linganiveth/esp32-wireless-intrusion-alarm/hardware/photos/README.md

# Build photographs

Photos of the hardware used in the report (`docs/report`) and the slides. Save them here with these names so the links stay valid:

| File | What it shows | Report figure |
|---|---|---|
| `hub_breadboard.jpg` | Hub: ESP32, keypad, OLED, LEDs and buzzer driver (top view) | Fig. 6.3 |
| `detector_enclosure.jpg` | Detector inside its box: PIR on top, tamper switch under the lid | Fig. 6.4 |
| `door_reed_mount.jpg` | Reed switch on the frame and magnet on the door | Fig. 6.5 |
| `phone_page.png` | Screenshot of http://192.168.4.1 | Fig. 7.5 |
| `system_setup.jpg` | Complete setup: hub on desk, detector at the door, phone | Fig. 8.1 |
| `oled_exit_delay.jpg` | OLED showing EXIT DELAY countdown | Fig. 8.2 |
| `alarm_state.jpg` | Hub in ALARM (OLED, ALARM LED) | Fig. 8.3 |
| `serial_logs.png` | Hub and detector serial monitors during validation | Fig. 8.4 |

Keep each photo under about 1 MB (resize to ~1600 px wide) so the repository stays small.
