linganiveth/esp32-wireless-intrusion-alarm/docs/daily_log/README.md

# Daily log: master checklist

One file per working day (`YYYY-MM-DD.md`). Status: Done / Partly done / Open.

| Date | Task | Design-flow stage | Status | Log |
|---|---|---|---|---|
| 2026-10-30 | Freeze topic, requirements, architecture; create repository structure | Requirements → Architecture | Done | [2026-10-30](2026-10-30.md) |
| 2026-11-01 | Board check, ESP-NOW ping, switch inputs, PIR (lessons 01–04) | Architecture check, HW design + test | Done | [2026-11-01](2026-11-01.md) |
| 2026-11-01 | Run HT2, HT3, HT6 | HW testing | Done | [2026-11-01](2026-11-01.md) |
| 2026-11-05 | Hub hardware (lesson 05), LED test (HT5) | HW implementation + test | Done (LEDs); keypad/OLED/siren values open | [2026-11-05](2026-11-05.md) |
| 2026-11-05 | Detector + hub firmware: protocol, FSM, supervision, phone page (lessons 07–10) | SW design + implementation | Done | [2026-11-05](2026-11-05.md) |
| 2026-11-05 | Schematics, demo plan | HW design, validation prep | Done | [2026-11-05](2026-11-05.md) |
| 2026-11-06 | Review slides; ST1–ST11; final demo (Review 1 + 2) | SW testing, validation | Partly done (results to be recorded) | [2026-11-06](2026-11-06.md) |
| 2026-11-09 | Project report; stage documents 01–08; repository completed | Report, O&M | Done | [2026-11-09](2026-11-09.md) |
| Open | Fill HT1, HT4, HT5 keypad/OLED, range, latency and ST results | Testing, validation | Open | — |
