linganiveth/esp32-wireless-intrusion-alarm/docs/02_specification/board_ids.md

# Board identities (recorded 2026-11-01, Lesson 01)

| Role | Label | STA MAC | C array | Chip |
|---|---|---|---|---|
| Hub | HUB (Board 1) | FC:E8:C0:75:C1:94 | `{0xFC, 0xE8, 0xC0, 0x75, 0xC1, 0x94}` | ESP32-D0WD-V3 rev v3.1, 4 MB flash |
| Detector | DET (Board 2) | D0:EF:76:33:EE:44 | `{0xD0, 0xEF, 0x76, 0x33, 0xEE, 0x44}` | ESP32-D0WD-V3 rev v3.1, 4 MB flash |

Toolchain: Arduino IDE 2.x, ESP32 Arduino core 3.x (chip revision reported as 301 = v3.1).
