linganiveth/esp32-wireless-intrusion-alarm/docs/daily_log/2026-10-30.md

# 2026-10-30

**Stage:** Requirements → Specification → Architecture

## Done
- Chose the topic: Ajax-style wireless home security system (detector + hub, ESP-NOW), sized for a 5-day build.
- Wrote the component list with purposes and prices: `hardware/bom/Home_Security_Component_List.xlsx`.
- Created the repository with one folder per design-flow stage and the learning roadmap (`docs/learning/00_roadmap.md`).

## Decisions
- Two ESP32 DevKit V1 boards; ESP-NOW instead of Wi-Fi/MQTT (no router needed).
- No RTOS: non-blocking super-loop.

## Next
- Buy parts; lesson 01 (toolchain, MAC addresses).
