linganiveth/esp32-wireless-intrusion-alarm/docs/daily_log/2026-11-01.md

# 2026-11-01

**Stage:** Architecture check, hardware design and testing (lessons 01–04)

## Done
- **L01 board check:** both boards ESP32-D0WD-V3 rev 3.1, 4 MB flash. MACs recorded in `docs/02_specification/board_ids.md` (hub FC:E8:C0:75:C1:94, detector D0:EF:76:33:EE:44).
- **L02 ESP-NOW ping (HT6):** 0 lost in 452 consecutive pings after start-up; RTT 2.4–3.0 ms typical, 28.8 ms max. Earlier losses (22, all before ping #358) were during start-up and unplug tests.
- **L03 switch inputs (HT3):** one debounced event per action. Reed: 1 raw edge; tamper lever: up to 31 raw edges. Log: `docs/06_testing/logs/L03_switch_inputs_2026-11-01.txt`.
- **L04 PIR (HT2):** 5/5 walk-pasts detected, output HIGH 1.06–2.55 s. Log: `docs/06_testing/logs/L04_pir_2026-11-01.txt`.

## Problems and fixes
- L04 compile error "'DebouncedInput' was not declared in this scope": the Arduino IDE inserted prototypes before the struct. Fixed by moving the struct into `debounced_input.h`.

## Open
- PIR range at 1/2/4 m, switch-pin voltages, 10 m radio range.
