linganiveth/esp32-wireless-intrusion-alarm/docs/daily_log/2026-11-05.md

# 2026-11-05

**Stage:** Hardware implementation (hub), software design and implementation

## Done
- **L05 hub hardware:** wired keypad, OLED, LEDs and BC547 siren driver (step-by-step guide in `docs/learning/05_hub_hardware.md`).
- **HT5:** all 4 LEDs pass, both in the L05 sketch and in the firmware state table.
- **Firmware (lessons 07–10 merged):** `firmware/detector_node` and `firmware/hub` with 12-byte packet + CRC, ACK/retry, duplicate filter, heartbeat/offline supervision, 5-state alarm FSM, PIN lockout, OLED, phone web page. Syntax-checked for ESP32 core 2.x and 3.x.
- **Phone page (ST10):** works from a laptop on the HomeGuard-Hub network. Fixed the page refreshing while the PIN was being typed.
- **Schematics:** `hardware/schematics/hub_schematic.pdf`, `detector_schematic.pdf` (generated by `tools/gen_schematics.py`).
- Demo plan: `docs/slides/demo_day_plan.md`.

## Open
- ST1–ST9, ST11; HT1, HT4 values; keypad and OLED part of HT5.
