linganiveth/esp32-wireless-intrusion-alarm/docs/daily_log/2026-11-06.md

# 2026-11-06

**Stage:** Software testing, validation, review

## Done
- Review presentation: `docs/slides/HomeGuard_ESD_Review.pptx` (18 slides following the design flow; Review 1 and Review 2 in one session).
- Prepared the morning bench check and the ST1–ST11 test procedure (`docs/06_testing/README.md`).
- Viva preparation: I2C/OLED, siren driver, LEDs, switch inputs, PIR, ESP-NOW, packet format.

## Open
- Record the ST results, latency and range measurements in `docs/06_testing` and `docs/07_integration_validation`.
