linganiveth/esp32-wireless-intrusion-alarm/docs/daily_log/2026-11-09.md

# 2026-11-09

**Stage:** Report, operation and maintenance, repository completion

## Done
- Project report in the department template: `docs/report/HomeGuard_Project_Report.docx` (+ PDF), chapters aligned with the design flow, photo placeholders for the hardware demo.
- Stage documents completed: `docs/01_requirements` … `docs/08_operation_maintenance`.
- Repository made reproducible: build guide in the root README, firmware README, tools (`sync_packet_h.py`, `latency_from_log.py`, `gen_schematics.py`), BOM summary, photo list, MIT licence; placeholder files removed.

## Open
- Add photos to `hardware/photos/` and the report; fill the remaining measured values (yellow cells in the report).
