linganiveth/esp32-wireless-intrusion-alarm/hardware/schematics/detector_schematic.pdf

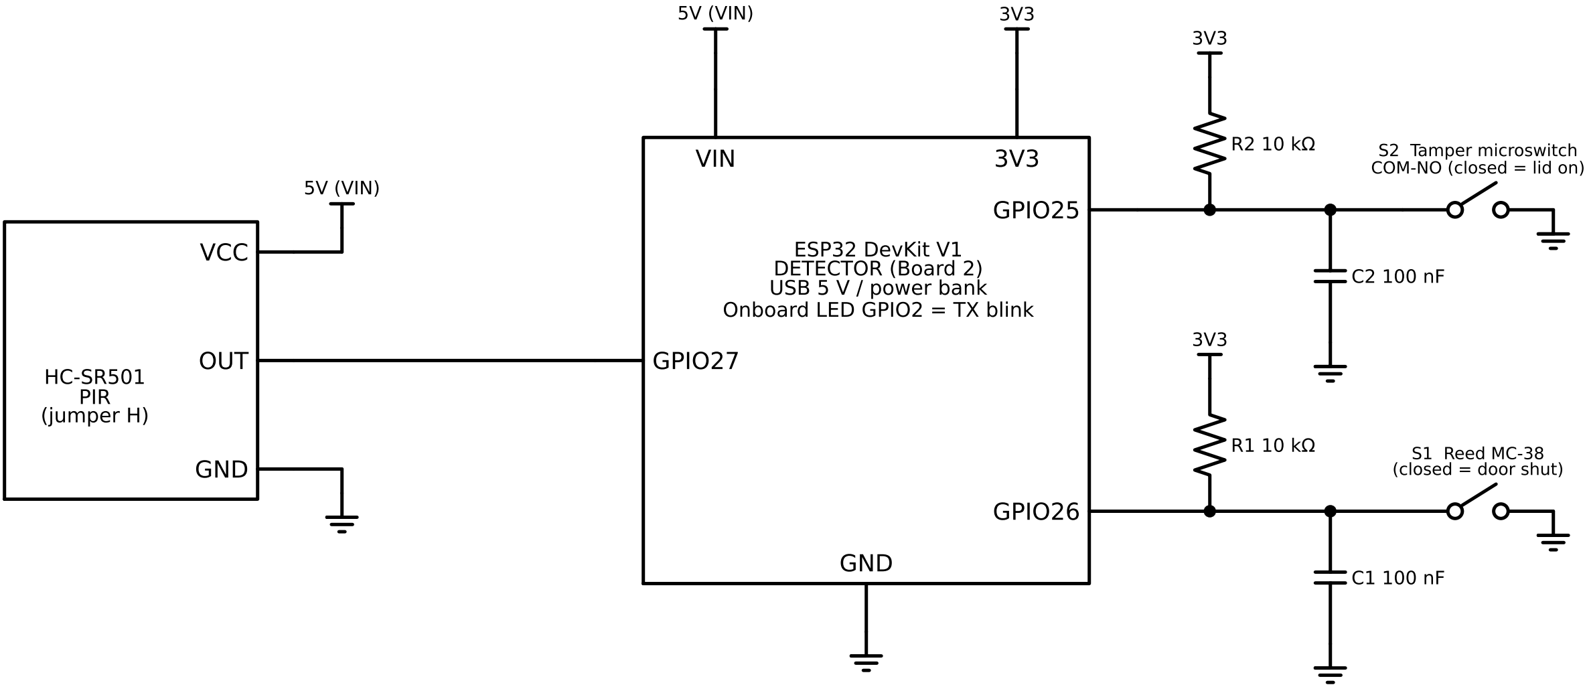
[picture p28: figure]
GPIO27; GPIO26; GPIO25; VIN; GND; ESP32 DevKit V1 DETECTOR (Board 2) USB 5 V / power bank Onboard LED GPIO2 = TX blink; 5V (VIN); S1 Reed MC-38 (closed = door shut); S2 Tamper microswitch COM-NO (closed = lid on); OUT; VCC; HC-SR501 PIR (jumper H)

### HomeGuard - DETECTOR schematic (25ES604 ESD mini-project) rev 1 2026-11-05

Fail-safe inputs: switch to GND + pull-up, so a cut wire reads OPEN (alarm side). Internal pull-up also enabled.
RC filter: 10 kΩ x 100 nF = 1 ms; firmware debounce 50 ms. PIR needs 5 V supply; OUT is 3.3 V logic (safe for GPIO).
