linganiveth/esp32-wireless-intrusion-alarm/hardware/bom/Home_Security_Component_List.xlsx

Sheet: Shopping List
Wireless Home Security System – Component Shopping List
Column K: parts already on your earlier lists (ECU / smart meter) – check your box before buying. Edit only blue cells. Prices are approximate Indian retail (Oct 2026).
# | Category | Component | Specification / ask for | Qty | Unit price (₹, approx) | Amount (₹) | Purpose | Where used (plan § / test) | Priority | On earlier lists? | Bought? (Yes/No)
1 | Boards | ESP32 DevKit V1 (ESP32-WROOM-32) | CP2102 or CH340 USB chip | 2 | ₹450 | ₹900 | One for the hub, one for the detector node; built-in Wi-Fi + ESP-NOW, so no extra radio | Hub + detector (§4) | 1 · Must buy (core) | ✔ On earlier list – check if you have it | No
2 | Boards | Micro-USB DATA cable | Data, not charge-only; check if your DevKit is USB-C | 2 | ₹80 | ₹160 | Flashing, serial logs for latency measurement, power | Both nodes | 1 · Must buy (core) | ✔ On earlier list – check if you have it | No
3 | Sensors | PIR motion sensor HC-SR501 | 5 V supply, 3.3 V output | 1 | ₹90 | ₹90 | Detects a person moving in the room (motion event) | Detector GPIO27; HT2, T2 | 1 · Must buy (core) | New | No
4 | Sensors | MC-38 wired magnetic reed door sensor | Switch + magnet pair | 1 | ₹70 | ₹70 | Detects the door opening (door event, entry delay) | Detector GPIO26; HT3, T3 | 1 · Must buy (core) | New | No
5 | Sensors | Micro limit switch with lever (SS-5GL / KW11) | Normally open | 2 | ₹15 | ₹30 | Tamper switch pressed by the detector box lid; spare | Detector GPIO25; HT3, T5 | 1 · Must buy (core) | New | No
6 | User interface | 4×4 membrane keypad | 8-pin | 1 | ₹70 | ₹70 | PIN entry, arm (A), enter (#), change PIN (*) | Hub; HT5, T1, T4 | 1 · Must buy (core) | New | No
7 | User interface | SSD1306 0.96" OLED, I2C, 4-pin | Address 0x3C | 1 | ₹180 | ₹180 | Shows state, exit/entry countdown, last event, detector online/offline | Hub GPIO21/22; HT5 | 1 · Must buy (core) | ✔ On earlier list – check if you have it | No
8 | Outputs | 5 V active buzzer, loud (~85 dB) | Active type (tone built in) | 1 | ₹25 | ₹25 | Siren in ALARM, chirp for countdown and faults | Hub GPIO25 via BC547; HT4, T2 | 1 · Must buy (core) | ✔ On earlier list – check if you have it | No
9 | Outputs | NPN transistor BC547 |  | 3 | ₹2 | ₹6 | Switches the buzzer current (~30 mA) from a 3.3 V GPIO; spares | Siren driver; HT4 | 1 · Must buy (core) | ✔ On earlier list – check if you have it | No
10 | Outputs | Diode 1N4148 or 1N5819 |  | 2 | ₹3 | ₹6 | Flyback protection if the buzzer is a magnetic type | Siren driver | 1 · Must buy (core) | ✔ On earlier list – check if you have it | No
11 | Outputs | LED 5 mm: green, yellow, red, blue |  | 6 | ₹2 | ₹12 | Ready, Armed, Alarm, Fault indicators | Hub GPIO26/27/14/13 | 1 · Must buy (core) | ✔ On earlier list – check if you have it | No
12 | Passives | Resistor 10 kΩ |  | 10 | ₹1 | ₹10 | Pull-ups for reed and tamper switches | Detector inputs; HT3 | 1 · Must buy (core) | ✔ On earlier list – check if you have it | No
13 | Passives | Resistor 1 kΩ |  | 5 | ₹1 | ₹5 | Transistor base resistor (Ib ≈ 2.6 mA) | Siren driver | 1 · Must buy (core) | ✔ On earlier list – check if you have it | No
14 | Passives | Resistor 330 Ω |  | 6 | ₹1 | ₹6 | LED current limiting (~4 mA) | Hub LEDs | 1 · Must buy (core) | ✔ On earlier list – check if you have it | No
15 | Passives | Capacitor 100 nF ceramic | code 104 | 10 | ₹2 | ₹20 | RC filter on switch inputs (τ = 1 ms) and supply decoupling | Detector inputs, both boards | 1 · Must buy (core) | ✔ On earlier list – check if you have it | No
16 | Enclosure | Small ABS project box (~100×60×25 mm) | With screw/snap lid | 1 | ₹80 | ₹80 | Detector housing; lid presses the tamper switch; PIR looks out through a hole | Detector; T5 | 1 · Must buy (core) | New | No
17 | Build | Breadboard 830 points |  | 1 | ₹90 | ₹90 | Hub circuit | Hub | 1 · Must buy (core) | ✔ On earlier list – check if you have it | No
18 | Build | Half breadboard 400 points | Fits inside the box | 1 | ₹60 | ₹60 | Detector circuit inside the box | Detector | 1 · Must buy (core) | New | No
19 | Build | Jumper wires male–male (40) |  | 1 | ₹70 | ₹70 | Breadboard wiring | Both | 1 · Must buy (core) | ✔ On earlier list – check if you have it | No
20 | Build | Jumper wires male–female (40) |  | 1 | ₹70 | ₹70 | Keypad, OLED, PIR and reed leads to the breadboard | Both | 1 · Must buy (core) | ✔ On earlier list – check if you have it | No
21 | Build | Male header strip 40-pin |  | 1 | ₹10 | ₹10 | Headers for modules supplied unsoldered | Modules | 1 · Must buy (core) | ✔ On earlier list – check if you have it | No
22 | Power | 5 V 1 A USB charger | Any phone charger | 1 | ₹150 | ₹150 | Hub power during the demo | Hub | 4 · Skip if already owned | New | No
23 | Power | USB power bank | Any | 1 | ₹500 | ₹500 | Detector power, so it can sit on the door | Detector | 4 · Skip if already owned | New | No
24 | Spares | PIR HC-SR501 (spare) |  | 1 | ₹90 | ₹90 | Backup if the PIR is faulty (they vary a lot) | Spare | 2 · Spare | New | No
25 | Stretch | RC522 RFID kit (reader + card + key tag) | SPI, 3.3 V | 1 | ₹150 | ₹150 | Disarm with a card instead of the PIN | Stretch | 3 · Stretch (only after T1–T7 pass) | New | No
26 | Stretch | 18650 cell + holder + TP4056 charger module |  | 1 | ₹250 | ₹250 | Battery-powered detector for the deep-sleep / battery-life measurement | Stretch (power design challenge) | 3 · Stretch (only after T1–T7 pass) | New | No
27 | Stretch | Resistor 100 kΩ |  | 2 | ₹1 | ₹2 | Battery voltage divider to an ADC1 pin for low-battery warning | Stretch | 3 · Stretch (only after T1–T7 pass) | ✔ On earlier list – check if you have it | No
28 | Stretch | Third ESP32 DevKit + PIR + reed switch |  | 1 | ₹610 | ₹610 | Second detector node (shows multi-detector supervision) | Stretch | 3 · Stretch (only after T1–T7 pass) | New | No
29 | Tools | Digital multimeter |  | 1 | ₹450 | ₹450 | Hardware tests HT1–HT4 | HT1–HT4 | 5 · Tool | ✔ On earlier list – check if you have it | No
 |  | TOTAL (all rows) |  |  |  | ₹4172
 |  | Spent so far (rows marked Yes) |  |  |  | ₹0

Sheet: Budget Summary
Budget by priority
Priority | Items | Amount (₹) | Note
1 · Must buy (core) | 21 | ₹1970 | Everything needed for the 5-day core build and tests T1–T7
2 · Spare | 1 | ₹90 | Backup PIR
3 · Stretch (only after T1–T7 pass) | 4 | ₹1012 | RFID, battery node, second detector – only if time remains
4 · Skip if already owned | 2 | ₹650 | Chargers / power bank you probably own
5 · Tool | 1 | ₹450 | Borrow from the lab if possible
Buy today (priorities 1 + 2) |  | ₹2060
Core cost of parts that are NOT on earlier lists |  | ₹400
Core cost of parts already on earlier lists (may already have) |  | ₹1570

Sheet: Shop Notes
Shopping notes
1. Check your box first: green rows in column K were on the ECU or smart-meter lists, so you may already have them.
2. ESP32: buy two identical DevKits (same USB chip) so one driver works for both; take DATA cables.
3. HC-SR501: check it has the two orange pots (sensitivity, time) and the H/L jumper.
4. MC-38: the wired type (two wires + magnet), not a wireless 433 MHz sensor.
5. Buzzer: ask for an ACTIVE 5 V buzzer (beeps when powered). A passive one needs a tone signal.
6. Project box: big enough for a half breadboard and an ESP32; the lid must press the limit switch lever when closed.
7. Unit prices are assumptions (typical Indian retail, Oct 2026) – overwrite the blue cells with what you pay.
